fahrrad-camper/anhaenger/hardware/thermal-ctrl/thermal-ctrl.kicad_pcb

## KiCad design hardware/thermal-ctrl/thermal-ctrl.kicad_pcb (2026-06-13)

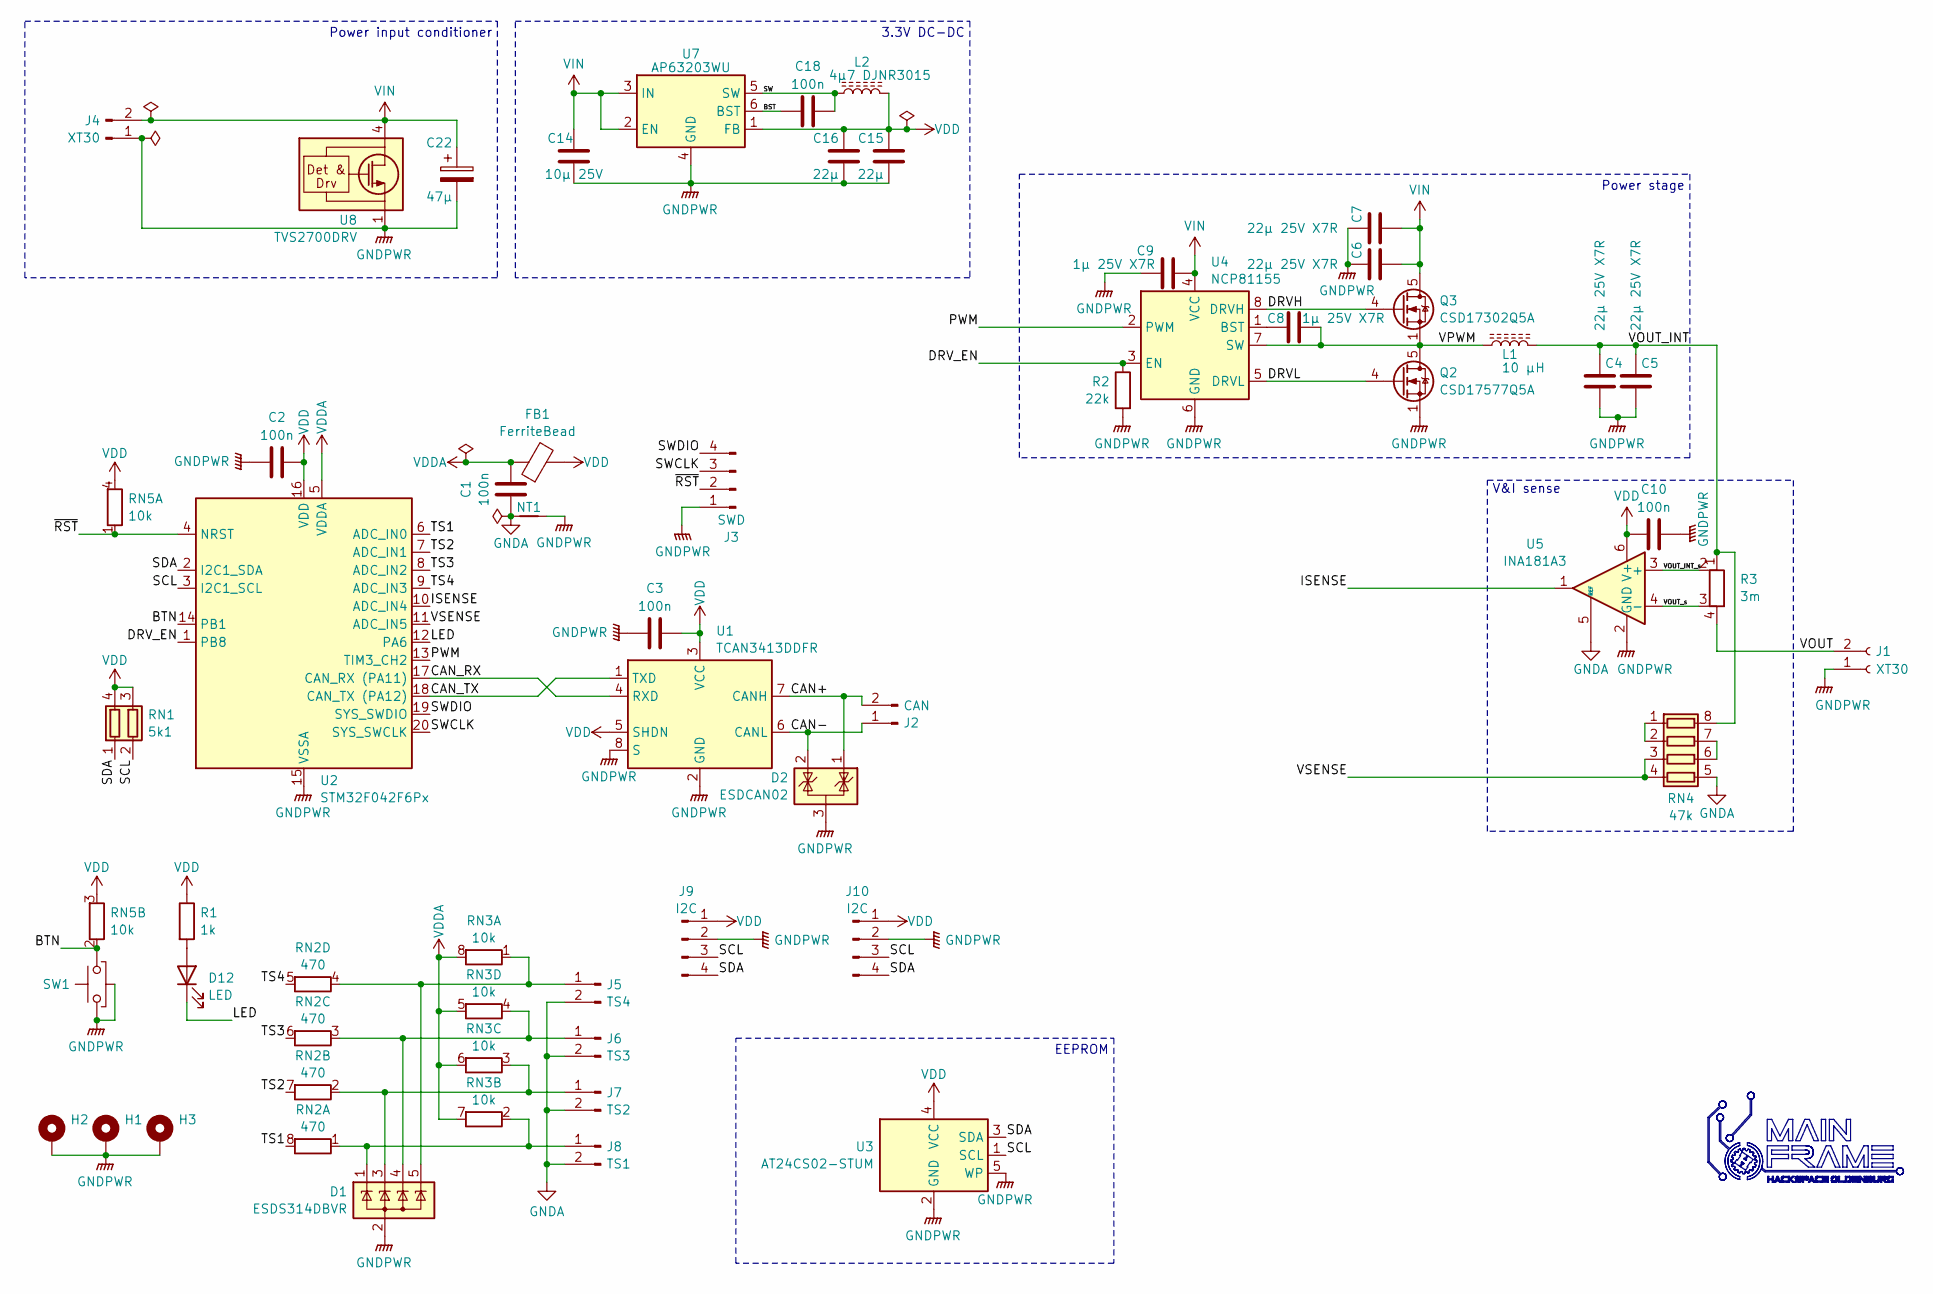
[picture p1: schematic thermal-ctrl.kicad_sch, Universal power board]

Parts:
C1, C2, C3, C10, C18: 100n; C_0603_1608Metric
C4, C5, C6, C7: 22µ 25V X7R; C_1210_3225Metric
C8, C9: 1µ 25V X7R; C_0603_1608Metric
C14: 10µ 25V; C_0805_2012Metric
C15, C16: 22µ; C_0805_2012Metric
C22: 47µ; CP_Elec_6.3x5.4
D1: ESDS314DBVR; SOT-23-5
D2: ESDCAN02; SOT-323_SC-70
D12: LED; LED_Kingbright_APDA3020VBCD
FB1: FerriteBead; L_0603_1608Metric
H1, H2, H3: M3; MountingHole_3.2mm_M3_ISO7380_Pad_TopBottom
J1: XT30; AMASS_XT30PW-F_1x02_P2.50mm_Horizontal
J2: CAN; PhoenixContact_MC_1,5_2-G-3.5_1x02_P3.50mm_Horizontal
J3: SWD; PinHeader_1x04_P1.27mm_Vertical
J4: XT30; AMASS_XT30PW-M_1x02_P2.50mm_Horizontal
J5: TS4; JST_XH_B2B-XH-A_1x02_P2.50mm_Vertical
J6: TS3; JST_XH_B2B-XH-A_1x02_P2.50mm_Vertical
J7: TS2; JST_XH_B2B-XH-A_1x02_P2.50mm_Vertical
J8: TS1; JST_XH_B2B-XH-A_1x02_P2.50mm_Vertical
J9, J10: I2C; JST_XH_B4B-XH-A_1x04_P2.50mm_Vertical
L1: 10 µH; L_Bourns_SRP1245A
L2: 4µ7 DJNR3015; L_Neosid_SMS-ME3015
NT1: NetTie_2; NetTie-2_SMD_Pad0.5mm
Q2: CSD17577Q5A; LFPAK56
Q3: CSD17302Q5A; LFPAK56
R1: 1k; R_0603_1608Metric
R2: 22k; R_0603_1608Metric
R3: 3m; R_Shunt_2512_6332Metric_KelvinConnection
RN1: 5k1; R_Array_Convex_2x0603
RN2: 470; R_Array_Convex_4x0603
RN3: 10k; R_Array_Convex_4x0603
RN4: 47k; R_Array_Convex_4x0603
RN5: 10k; R_Array_Convex_2x0603
SW1: SW_Tactile_SPST_Angled_PTS645Vx31-2LFS
U1: TCAN3413DDFR; TSOT-23-8
U2: STM32F042F6Px; TSSOP-20_4.4x6.5mm_P0.65mm
U3: AT24CS02-STUM; SOT-353_SC-70-5
U4: NCP81155; DFN-8-1EP_3x3mm_P0.5mm_EP1.55x1.85mm
U5: INA181A3; SOT-23-6
U7: AP63203WU; TSOT-23-6
U8: TVS2700DRV; WSON-6-1EP_2x2mm_P0.65mm_EP1x1.6mm

Connections:
/BST: C18.1, U7.6 (BST)
/BTN: RN5.2 (R2.1), SW1.2, U2.14 (PB1)
/CAN+: D2.1 (K), J2.2, U1.7 (CANH)
/CAN-: D2.2 (K), J2.1, U1.6 (CANL)
/CAN_RX: U1.4 (RXD), U2.17 (CAN_RX (PA11))
/CAN_TX: U1.1 (TXD), U2.18 (CAN_TX (PA12))
/DRVH: Q3.4 (G), U4.8 (DRVH)
/DRVL: Q2.4 (G), U4.5 (DRVL)
/DRV_EN: R2.1, U2.1 (PB8), U4.3 (EN)
/ISENSE: U2.10 (ADC_IN4), U5.1
/LED: D12.1 (K), U2.12 (PA6)
/PWM: U2.13 (TIM3_CH2), U4.2 (PWM)
/SCL: J9.3, J10.3, RN1.2 (R2.1), U2.3 (I2C1_SCL), U3.1 (SCL)
/SDA: J9.4, J10.4, RN1.1 (R1.1), U2.2 (I2C1_SDA), U3.3 (SDA)
/SW: C18.2, L2.1, U7.5 (SW)
/SWCLK: J3.3, U2.20 (SYS_SWCLK)
/SWDIO: J3.4, U2.19 (SYS_SWDIO)
/TS1: RN2.8 (R1.2), U2.6 (ADC_IN0)
/TS2: RN2.7 (R2.2), U2.7 (ADC_IN1)
/TS3: RN2.6 (R3.2), U2.8 (ADC_IN2)
/TS4: RN2.5 (R4.2), U2.9 (ADC_IN3)
/VOUT: J1.2, R3.4
/VOUT_INT: C4.1, C5.1, L1.2, R3.1, RN4.8 (R1.2)
/VOUT_INT_s: R3.2, U5.3 (+)
/VOUT_s: R3.3, U5.4 (-)
/VPWM: C8.2, L1.1, Q2.5 (D), Q3.1 (S), Q3.2 (S), Q3.3 (S), U4.7 (SW)
/VSENSE: RN4.3 (R3.1), RN4.4 (R4.1), U2.11 (ADC_IN5)
/~RST: J3.2, RN5.1 (R1.1), U2.4 (NRST)
GNDA: C1.1, J5.2, J6.2, J7.2, J8.2, NT1.1, RN4.5 (R4.2), U5.5 (REF)
GNDPWR: C2.1, C3.1, C4.2, C5.2, C6.1, C7.1, C9.1, C10.1, C14.1, C15.1, C16.1, C22.2, D1.2 (A), D2.3 (A), H1.1, H2.1, H3.1, J1.1, J3.1, J4.1, J9.2, J10.2, NT1.2, Q2.1 (S), Q2.2 (S), Q2.3 (S), R2.2, SW1.1, SW1.MP, U1.2 (GND), U1.8 (S), U2.15 (VSSA), U3.2 (GND), U3.5 (WP), U4.6 (GND), U4.9 (FLAG), U5.2 (GND), U7.4 (GND), U8.1 (GND), U8.2 (GND), U8.3 (GND), U8.7 (GND)
unnamed: D12.2 (A), R1.2
unnamed: D1.5 (K), J5.1, RN2.4 (R4.1), RN3.1 (R1.1)
unnamed: D1.4 (K), J6.1, RN2.3 (R3.1), RN3.4 (R4.1)
unnamed: D1.3 (K), J7.1, RN2.2 (R2.1), RN3.3 (R3.1)
unnamed: D1.1 (K), J8.1, RN2.1 (R1.1), RN3.2 (R2.1)
unnamed: RN4.1 (R1.1), RN4.2 (R2.1)
unnamed: RN4.6 (R3.2), RN4.7 (R2.2)
unnamed: C8.1, U4.1 (BST)
VDD: C2.2, C3.2, C10.2, C15.2, C16.2, FB1.2, J9.1, J10.1, L2.2, R1.1, RN1.3 (R2.2), RN1.4 (R1.2), RN5.3 (R2.2), RN5.4 (R1.2), U1.3 (VCC), U1.5 (SHDN), U2.16 (VDD), U3.4 (VCC), U5.6 (V+), U7.1 (FB)
VDDA: C1.2, FB1.1, RN3.5 (R4.2), RN3.6 (R3.2), RN3.7 (R2.2), RN3.8 (R1.2), U2.5 (VDDA)
VIN: C6.2, C7.2, C9.2, C14.2, C22.1, J4.2, Q3.5 (D), U4.4 (VCC), U7.2 (EN), U7.3 (IN), U8.4 (IN), U8.5 (IN), U8.6 (IN)

Notes on the sheet:
EEPROM
Power stage
Power input conditioner
V&I sense
3.3V DC-DC

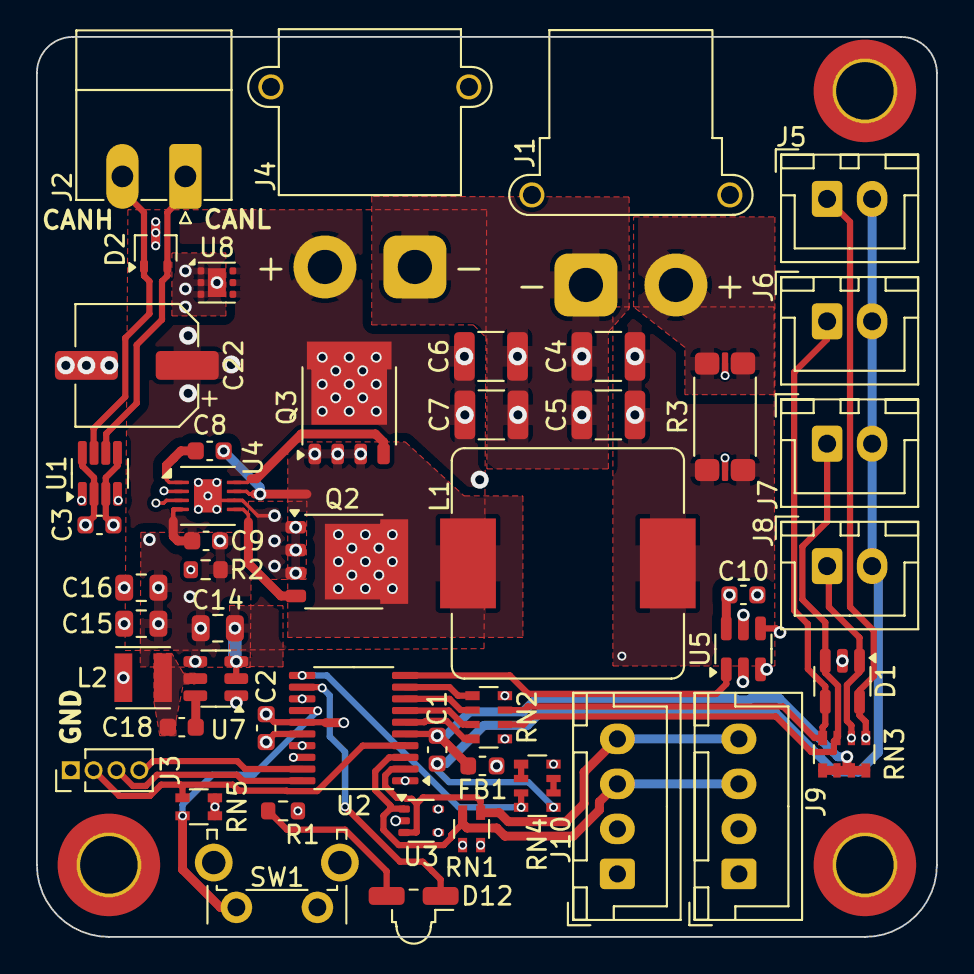
[picture p2: board thermal-ctrl.kicad_pcb from above]

Board: 6 copper layers, 50.0 x 50.0 mm, 53 parts (0 on the bottom side), 41 nets.
