fahrrad-camper/anhaenger/(notices)

Notices in the files:
hardware/thermal-ctrl/thermal-ctrl.kicad_pcb:
CC-BY-NC-SA Alexey Galakhov
